ManhTi3012/DroneSwarm/README.md

# MiniDrone

<p align="center" style="display: flex; gap: 10px;">
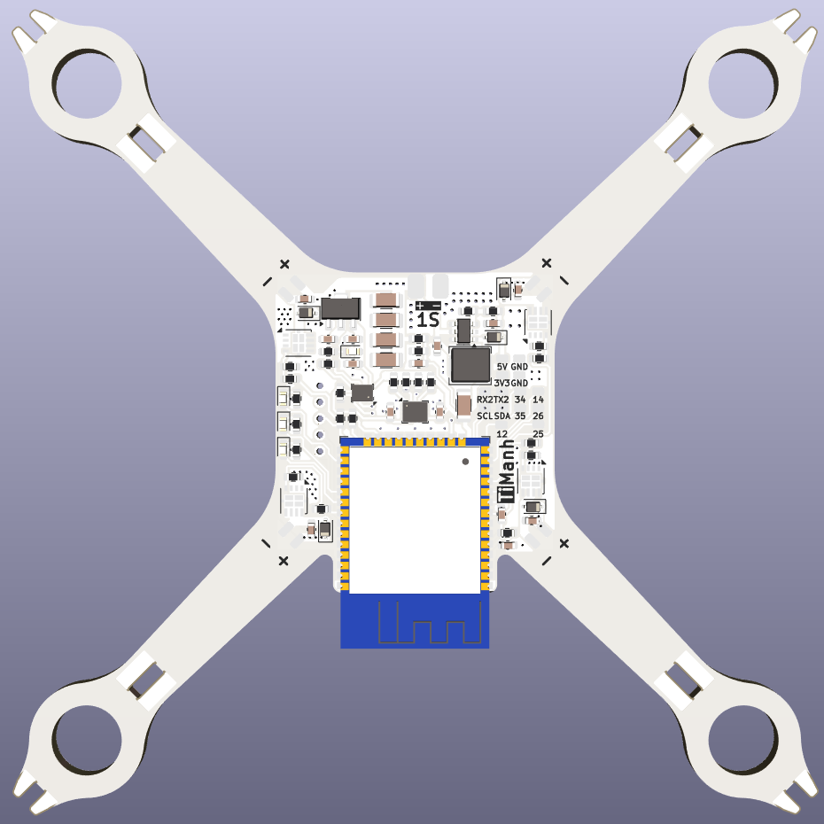
[picture p1: Photos/render.png]
  
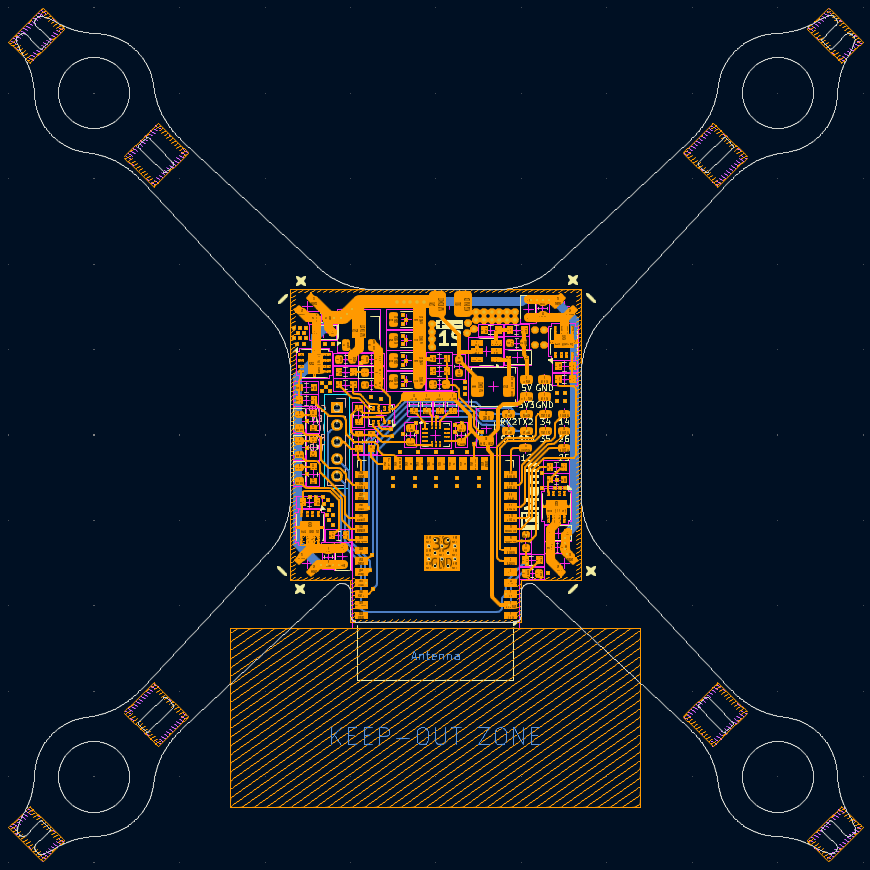
[picture p2: Photos/pcb.png]
  
</p>
