ManhTi3012/DroneSwarm/hardware/drone.SLDASM

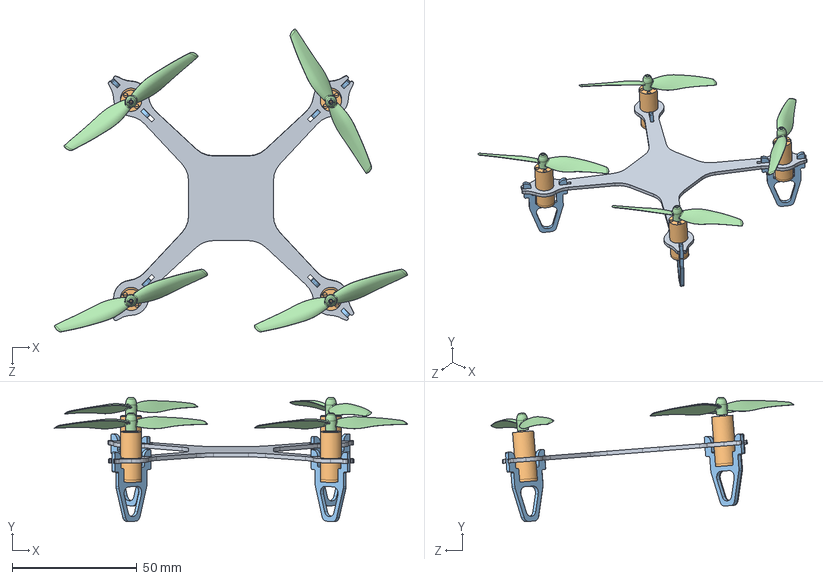
[picture p3: CAD file, 2025-09-14]
hardware/drone.SLDASM
141.4 x 49.8 x 121.3 mm
Main_Frame
8520 Coreless Brshed motor.step x 4
Leg x 4
65mm Press-Fit Prop.step x 4
