ManhTi3012/DroneSwarm/hardware/Main_Frame.SLDPRT

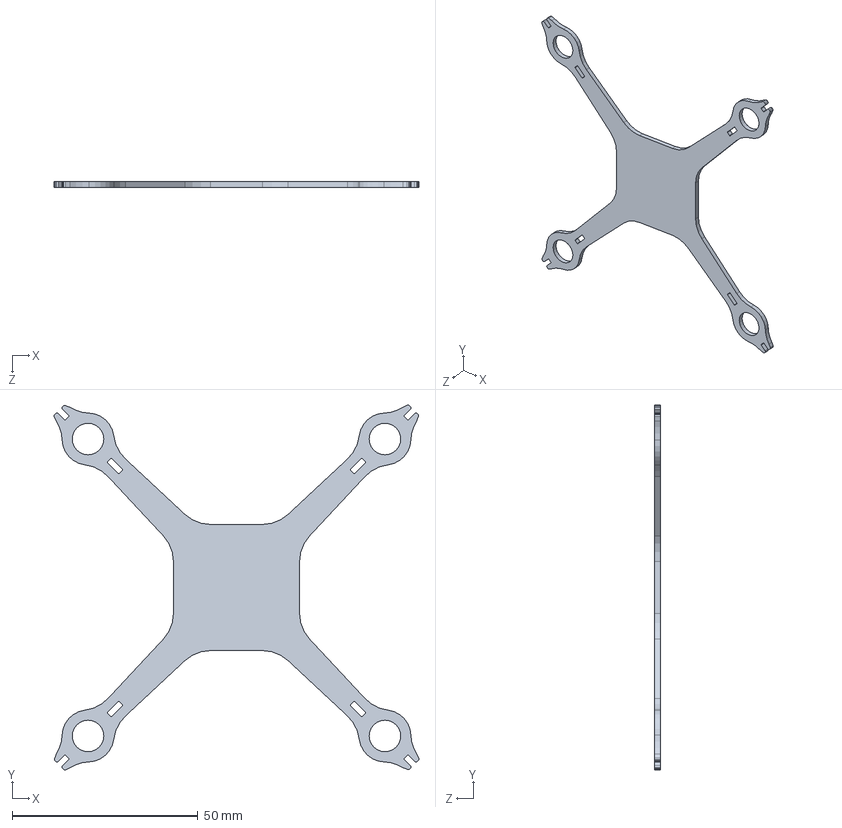
[picture p4: CAD file, 2025-09-14]
hardware/Main_Frame.SLDPRT
98.3 x 98.3 x 1.60 mm
