ManhTi3012/DroneSwarm/hardware/#Main_Frame_outline.DXF

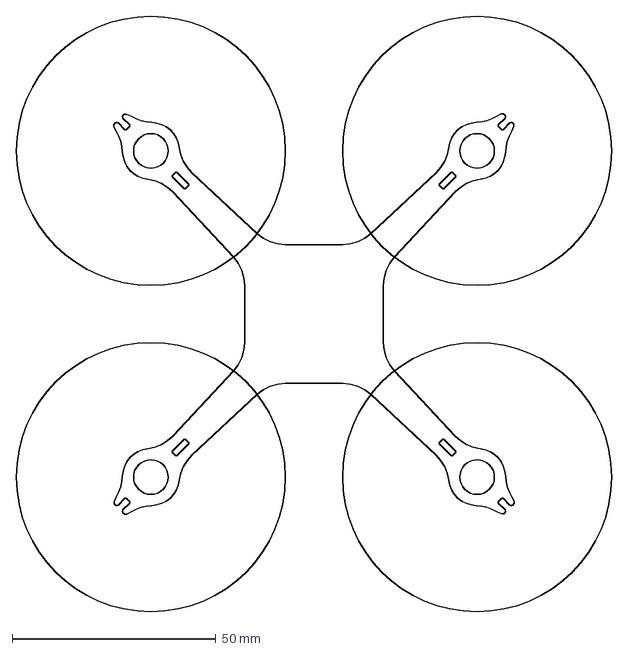
[picture p5: CAD file, 2025-09-14]
hardware/#Main_Frame_outline.DXF
146.0 x 146.0 mm
