ManhTi3012/DroneSwarm/hardware/Leg.SLDPRT

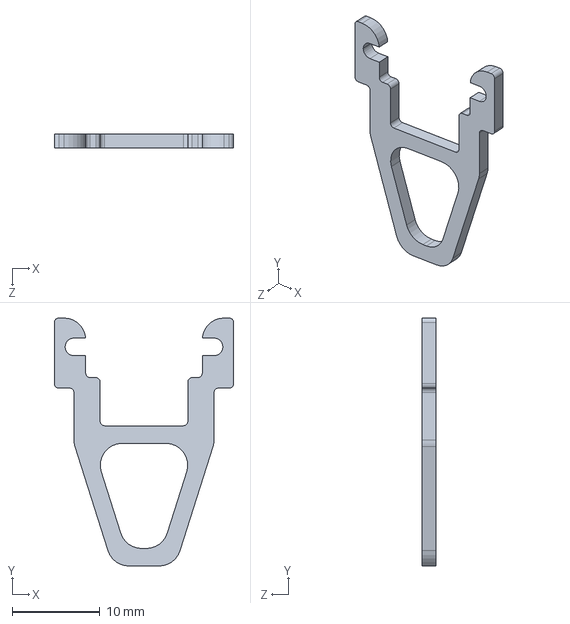
[picture p6: CAD file, 2025-09-14]
hardware/Leg.SLDPRT
20.5 x 28.3 x 1.60 mm
