ManhTi3012/DroneSwarm/hardware/8520 Coreless Brshed motor.step

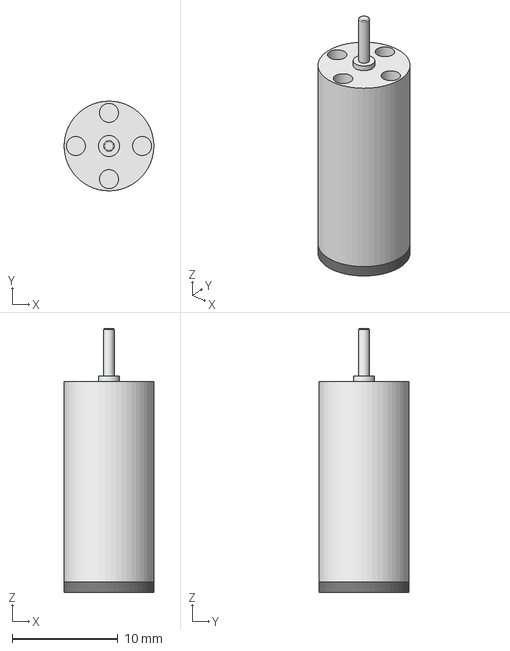
[picture p7: CAD file, 2025-09-14]
hardware/8520 Coreless Brshed motor.step
8.50 x 8.50 x 25.0 mm
