ManhTi3012/DroneSwarm/hardware/Propeller (Drone).SLDPRT

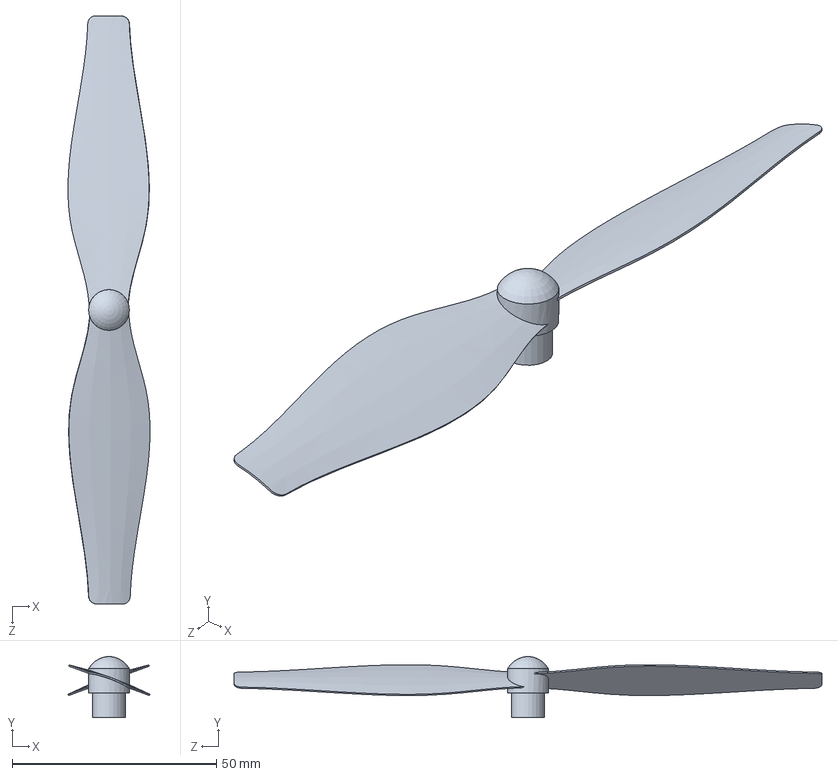
[picture p8: CAD file, 2025-09-14]
hardware/Propeller (Drone).SLDPRT
20.1 x 15.0 x 144.0 mm
