ManhTi3012/DroneSwarm/hardware/6045 R.STEP

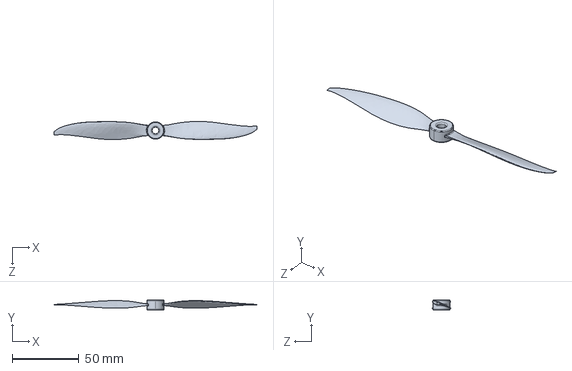
[picture p9: CAD file, 2025-09-14]
hardware/6045 R.STEP
152.4 x 7.25 x 13.6 mm
