ManhTi3012/DroneSwarm/hardware/65mm Press-Fit Prop.step

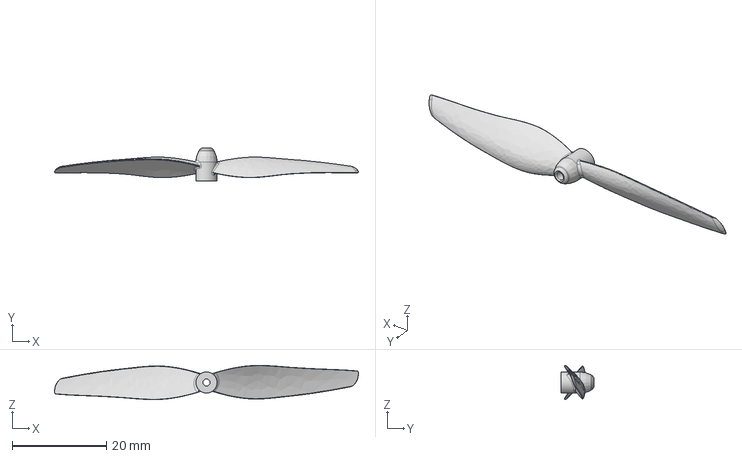
[picture p10: CAD file, 2025-09-14]
hardware/65mm Press-Fit Prop.step
64.7 x 6.95 x 7.27 mm
