ManhTi3012/DroneSwarm/(list of files, cad)

Other CAD files:
hardware/Leg.DXF
hardware/Leg.STL
hardware/Main_Frame.DXF
hardware/Main_Frame_outline.DXF
