ManhTi3012/DroneSwarm/PCB/drone_swarm.kicad_pcb

## KiCad design PCB/drone_swarm.kicad_pcb (2025-07-06)

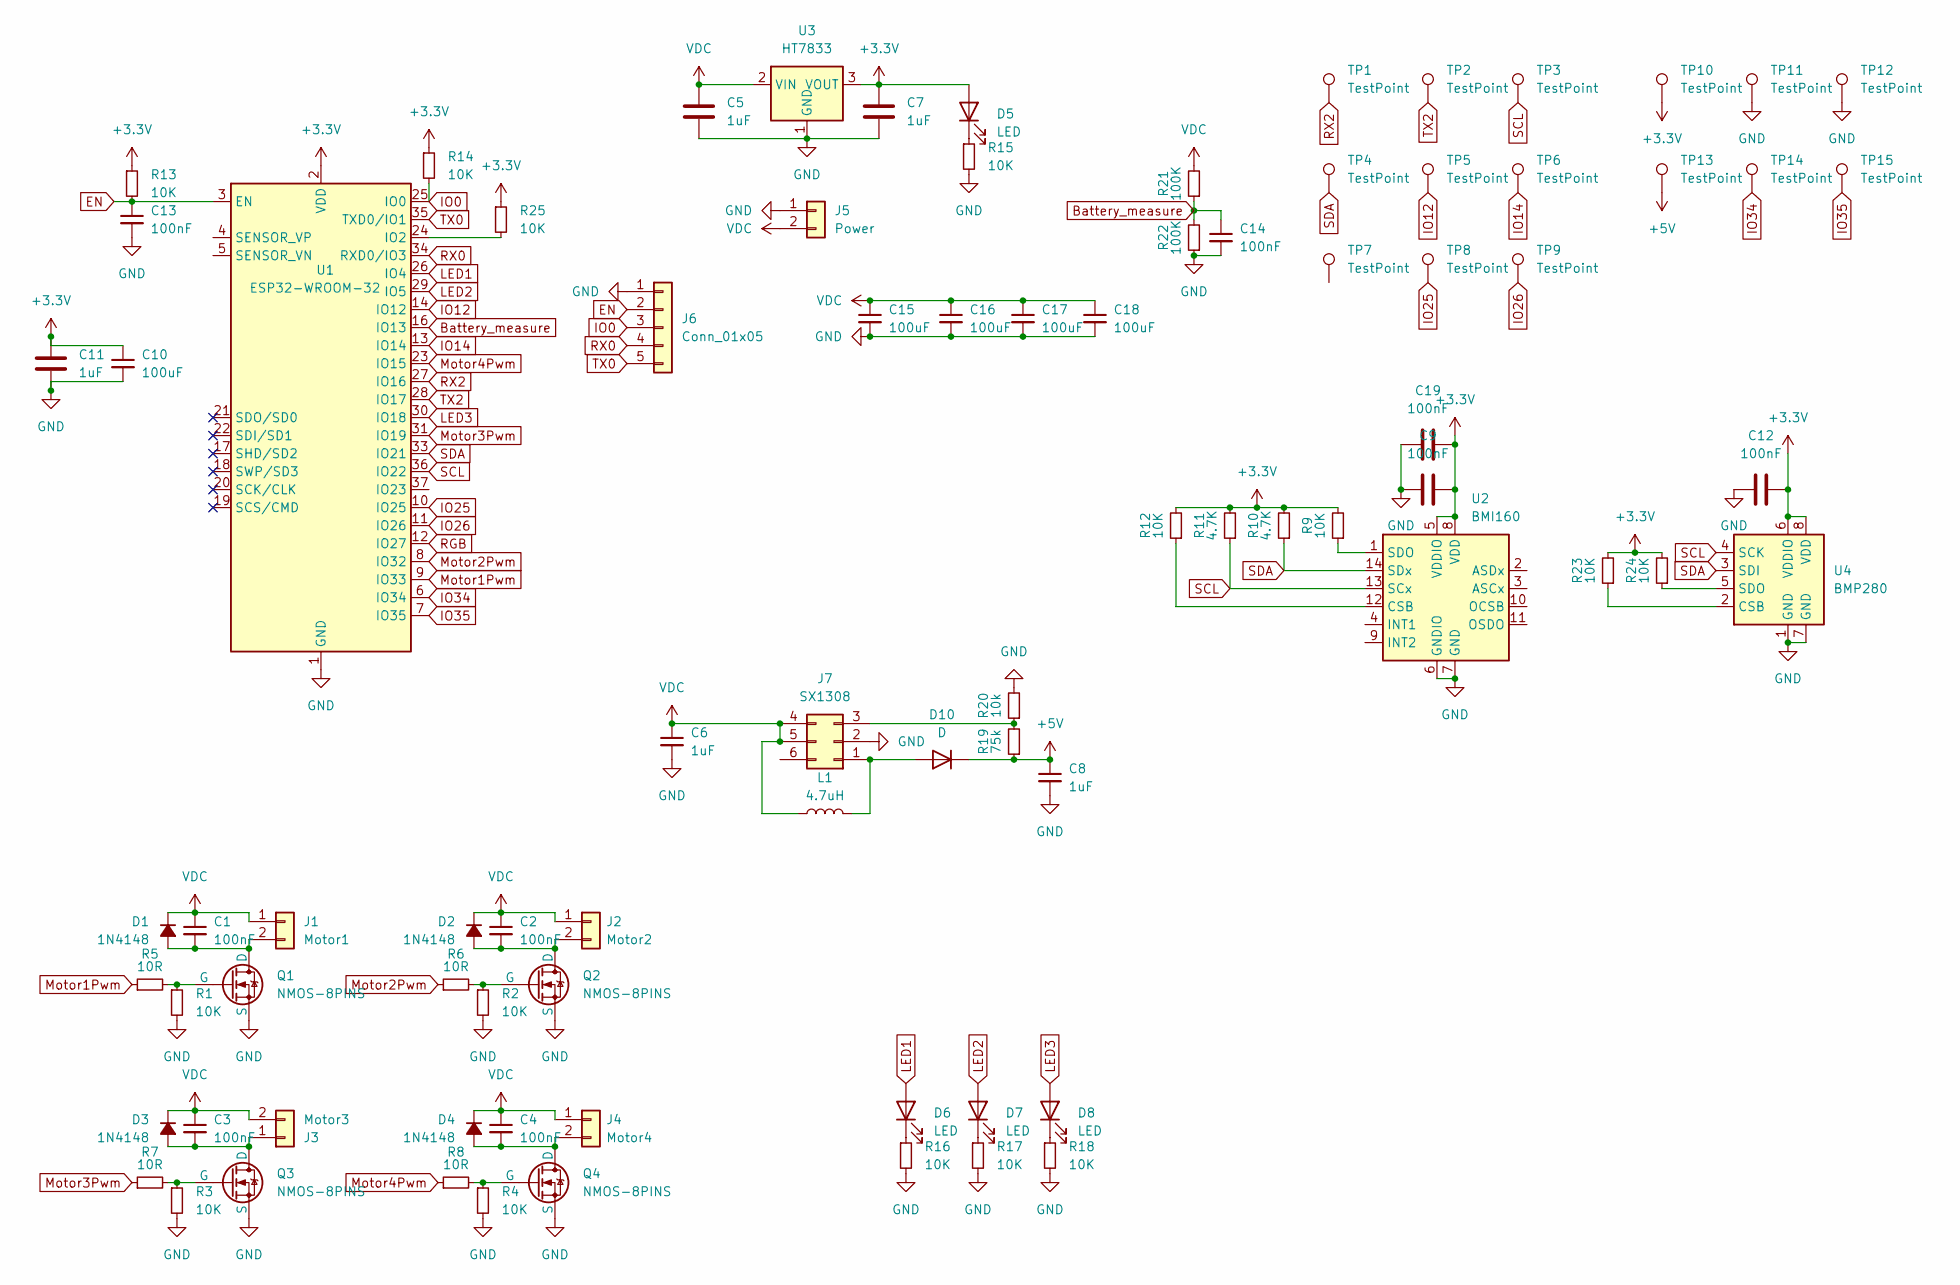
[picture p11: schematic drone_swarm.kicad_sch]

Parts:
C1, C2, C3, C4, C9, C12, C13, C14, C19: 100nF; C_0603_1608Metric
C5, C6, C7, C8, C11: 1uF; C_0603_1608Metric
C10, C15, C16, C17, C18: 100uF; C_1206_3216Metric
D1, D2, D3, D4: 1N4148; D_SOD-323
D5, D6, D7, D8: LED; LED_0603_1608Metric
D10: D; D_SOD-323
J1: Motor1; DualPad_1x2mm
J2: Motor2; DualPad_1x2mm
J3: Motor3; DualPad_1x2mm
J4: Motor4; DualPad_1x2mm
J5: Power; DualPad_2x3mm
J6: Conn_01x05; PinHeader_1x05_P2.00mm_Vertical
J7: SX1308; SOT-23-6
L1: 4.7uH; L_Chilisin_BMRA00040420
Q1, Q2, Q3, Q4: NMOS-8PINS; DFN8_3X3_EP_AOS
R1, R2, R3, R4, R9, R12, R13, R14, R15, R16, R17, R18, R23, R24, R25: 10K; R_0603_1608Metric
R5, R6, R7, R8: 10R; R_0603_1608Metric
R10, R11: 4.7K; R_0603_1608Metric
R19: 75k; R_0603_1608Metric
R20: 10k; R_0603_1608Metric
R21, R22: 100K; R_0603_1608Metric
TP1, TP2, TP3, TP4, TP5, TP6, TP7, TP8, TP9, TP10, TP11, TP12, TP13, TP14, TP15: TestPoint; Pad_1x1mm
U1: ESP32-WROOM-32
U2: BMI160; Bosch_LGA-14_3x2.5mm_P0.5mm
U3: HT7833; SOT-89-3
U4: BMP280; Bosch_LGA-8_2x2.5mm_P0.65mm_ClockwisePinNumbering

Connections:
+3.3V: C7.1, C9.2, C10.1, C11.1, C12.2, C19.2, D5.2 (A), R9.2, R10.2, R11.2, R12.2, R13.1, R14.1, R23.2, R24.2, R25.1, TP10.1, U1.2 (VDD), U2.5 (VDDIO), U2.8 (VDD), U3.3 (VOUT), U4.6 (VDDIO), U4.8 (VDD)
+5V: C8.1, D10.1 (K), R19.1, TP13.1
Battery_measure: C14.1, R21.1, R22.2, U1.16 (IO13)
EN: C13.1, J6.2, R13.2, U1.3 (EN)
GND: C5.2, C6.2, C7.2, C8.2, C9.1, C10.2, C11.2, C12.1, C13.2, C14.2, C15.2, C16.2, C17.2, C18.2, C19.1, J5.1, J6.1, J7.2, Q1.1 (S), Q1.2 (S), Q1.3 (S), Q2.1 (S), Q2.2 (S), Q2.3 (S), Q3.1 (S), Q3.2 (S), Q3.3 (S), Q4.1 (S), Q4.2 (S), Q4.3 (S), R1.2, R2.2, R3.2, R4.2, R15.2, R16.2, R17.2, R18.2, R20.2, R22.1, TP11.1, TP12.1, U1.1 (GND), U1.15 (GND), U1.38 (GND), U1.39 (GND), U2.6 (GNDIO), U2.7 (GND), U3.1 (GND), U4.1 (GND), U4.7 (GND)
IO0: J6.3, R14.2, U1.25 (IO0)
IO12: TP5.1, U1.14 (IO12)
IO14: TP6.1, U1.13 (IO14)
IO25: TP8.1, U1.10 (IO25)
IO26: TP9.1, U1.11 (IO26)
IO34: TP14.1, U1.6 (IO34)
IO35: TP15.1, U1.7 (IO35)
LED1: D6.2 (A), U1.26 (IO4)
LED2: D7.2 (A), U1.29 (IO5)
LED3: D8.2 (A), U1.30 (IO18)
Motor1Pwm: R5.1, U1.9 (IO33)
Motor2Pwm: R6.1, U1.8 (IO32)
Motor3Pwm: R7.1, U1.31 (IO19)
Motor4Pwm: R8.1, U1.23 (IO15)
unnamed: C1.2, D1.2 (A), J1.2, Q1.5 (D), Q1.6 (D), Q1.7 (D), Q1.8 (D)
unnamed: C2.2, D2.2 (A), J2.2, Q2.5 (D), Q2.6 (D), Q2.7 (D), Q2.8 (D)
unnamed: C3.2, D3.2 (A), J3.1, Q3.5 (D), Q3.6 (D), Q3.7 (D), Q3.8 (D)
unnamed: C4.2, D4.2 (A), J4.2, Q4.5 (D), Q4.6 (D), Q4.7 (D), Q4.8 (D)
unnamed: D5.1 (K), R15.1
unnamed: D6.1 (K), R16.1
unnamed: D7.1 (K), R17.1
unnamed: D8.1 (K), R18.1
unnamed: D10.2 (A), J7.1, L1.2
unnamed: J7.3, R19.2, R20.1
unnamed: Q1.4 (G), R1.1, R5.2
unnamed: Q2.4 (G), R2.1, R6.2
unnamed: Q3.4 (G), R3.1, R7.2
unnamed: Q4.4 (G), R4.1, R8.2
unnamed: R25.2, U1.24 (IO2)
unnamed: R12.1, U2.12 (CSB)
unnamed: R9.1, U2.1 (SDO)
unnamed: R23.1, U4.2 (CSB)
unnamed: R24.1, U4.5 (SDO)
RGB: U1.12 (IO27)
RX0: J6.4, U1.34 (RXD0/IO3)
RX2: TP1.1, U1.27 (IO16)
SCL: R11.1, TP3.1, U1.36 (IO22), U2.13 (SCx), U4.4 (SCK)
SDA: R10.1, TP4.1, U1.33 (IO21), U2.14 (SDx), U4.3 (SDI)
TX0: J6.5, U1.35 (TXD0/IO1)
TX2: TP2.1, U1.28 (IO17)
VDC: C1.1, C2.1, C3.1, C4.1, C5.1, C6.1, C15.1, C16.1, C17.1, C18.1, D1.1 (K), D2.1 (K), D3.1 (K), D4.1 (K), J1.1, J2.1, J3.2, J4.1, J5.2, J7.4, J7.5, L1.1, R21.2, U3.2 (VIN)

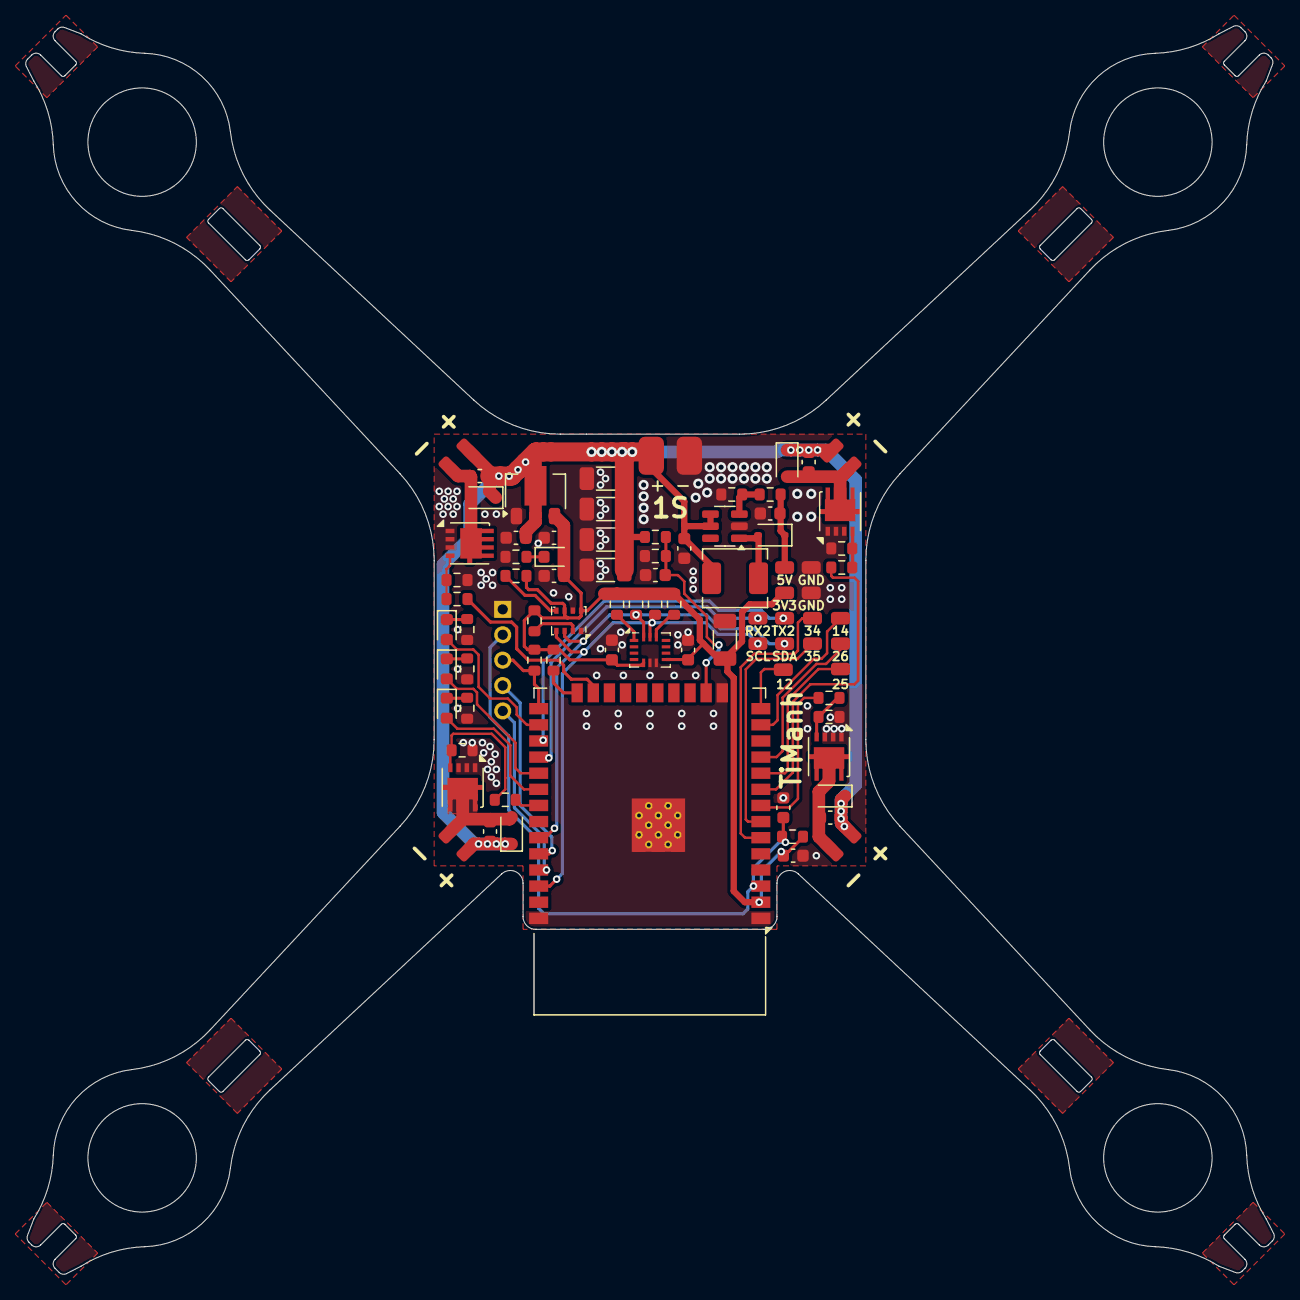
[picture p12: board drone_swarm.kicad_pcb from above]

Board: 2 copper layers, 98.3 x 98.3 mm, 83 parts (1 on the bottom side), 45 nets.
