ManhTi3012/DroneSwarm/firmware/Drone_Swarm_Arduino/include/constant.h

/*
 * constant.h
 *
 *  Created on: May 30, 2025
 *      Author: Ti Manh
 */

#ifndef CONSTANT_H_
#define CONSTANT_H_

#define MAX_PWM 1023

#define LED1 4
#define LED2 5
#define LED3 18

#define MOTOR_FL 15
#define MOTOR_FR 33
#define MOTOR_BL 19
#define MOTOR_BR 32

#define PWM_FREQ 10000
#define PWM_RES 10
#endif
